attowatt/frekvensHack/README.md

# frekvensHack

[Open the case](#open-the-case)  
[Rewire](#rewire)  
[Make a cable hole](#make-a-cable-hole)  
[Reassemble](#reassemble) 

[Firmware](#firmware) 

[Sources](#sources) 

## Open the case

Open the four screws on the back.

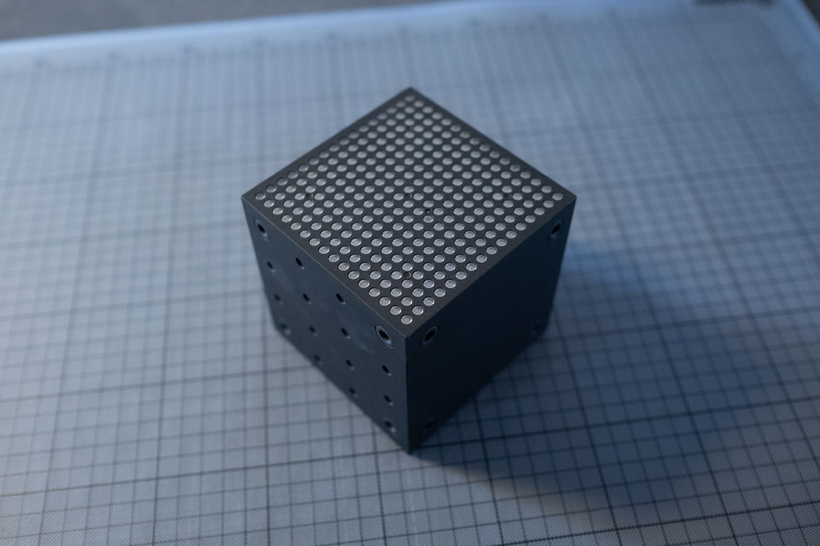
[picture p1: pictures/001.jpg]

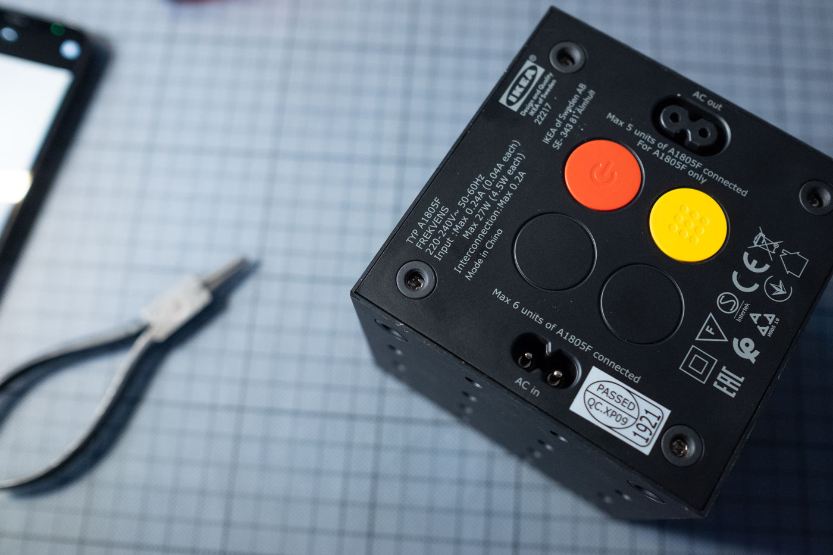
[picture p2: pictures/002.jpg]

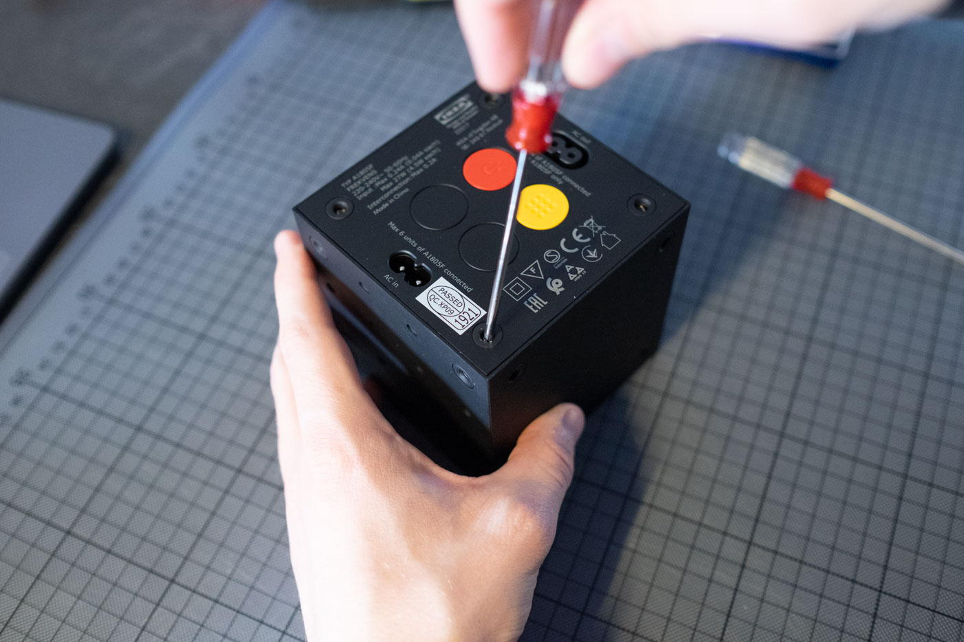
[picture p3: pictures/003.jpg]


Pry open back plate. It is glued, so it might take some light force.

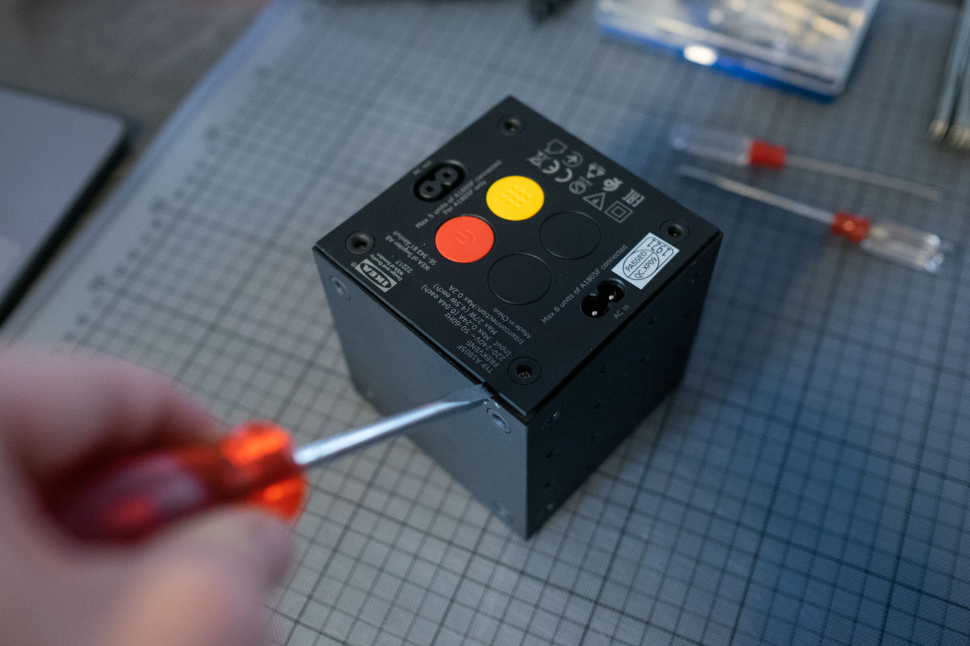
[picture p4: pictures/004.jpg]

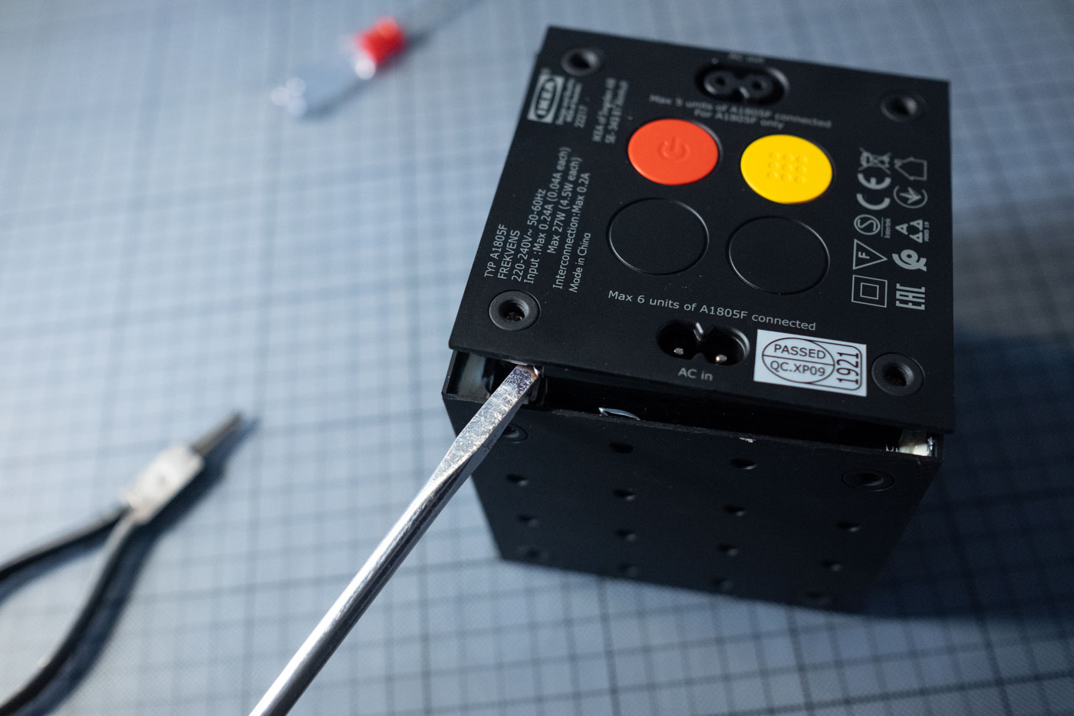
[picture p5: pictures/005.jpg]

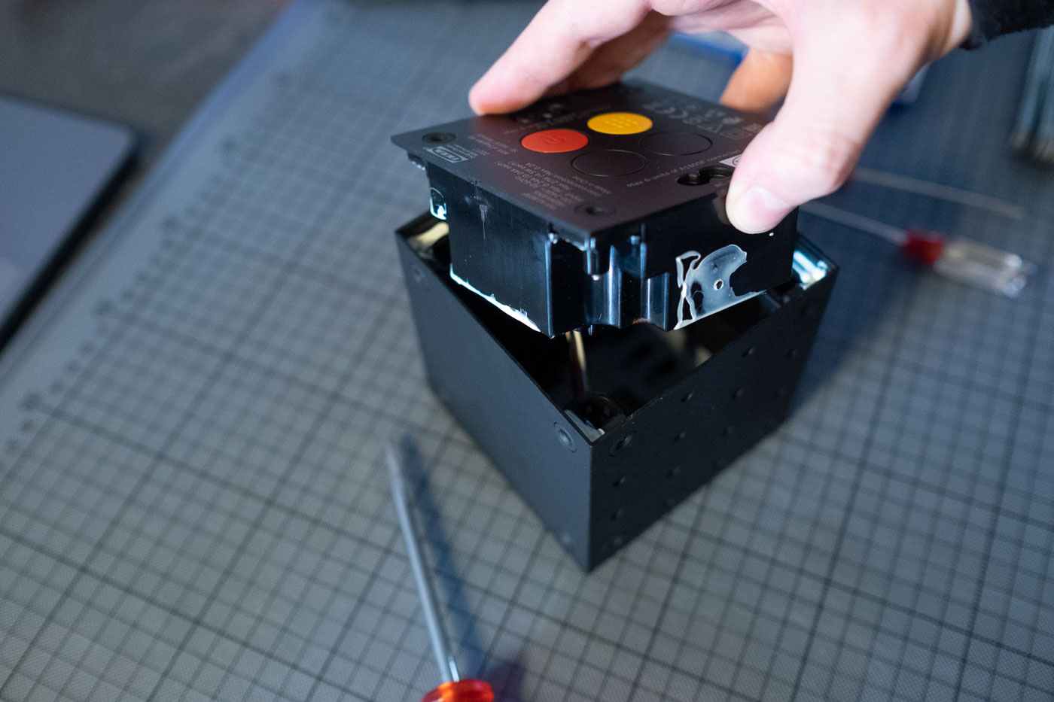
[picture p6: pictures/006.jpg]

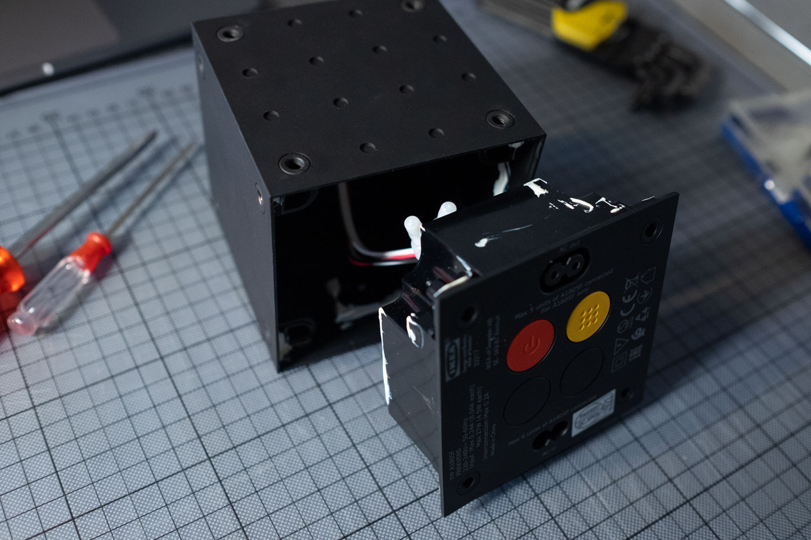
[picture p7: pictures/007.jpg]


Remove the four little corner spacers of the inner frame, each holding two screw nuts in place.

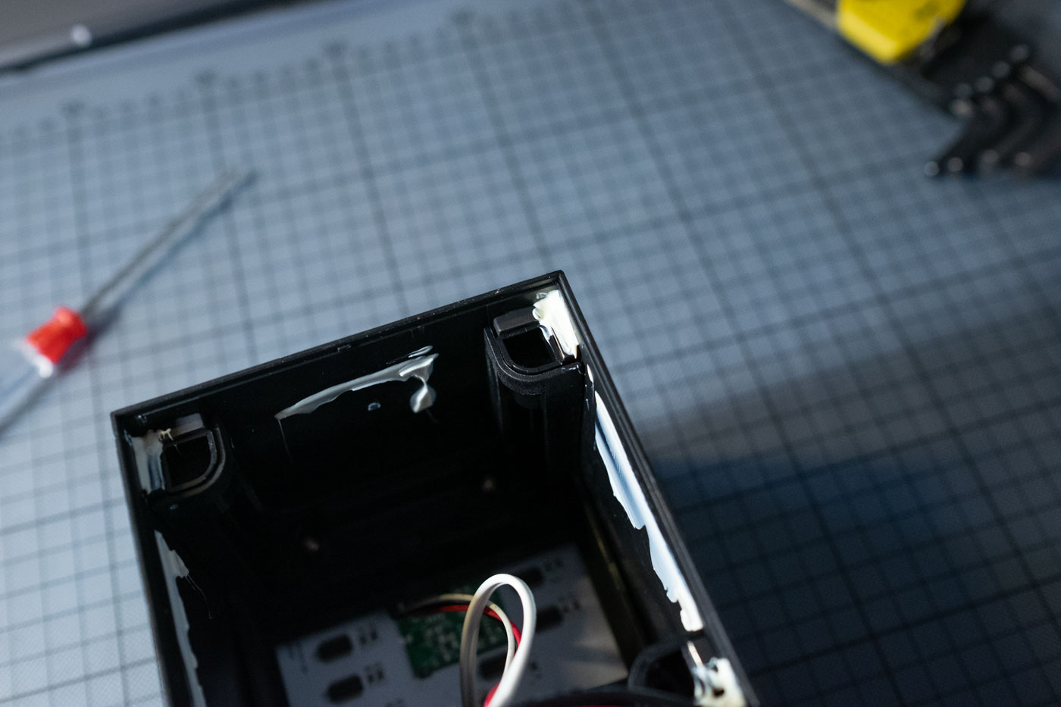
[picture p8: pictures/008.jpg]

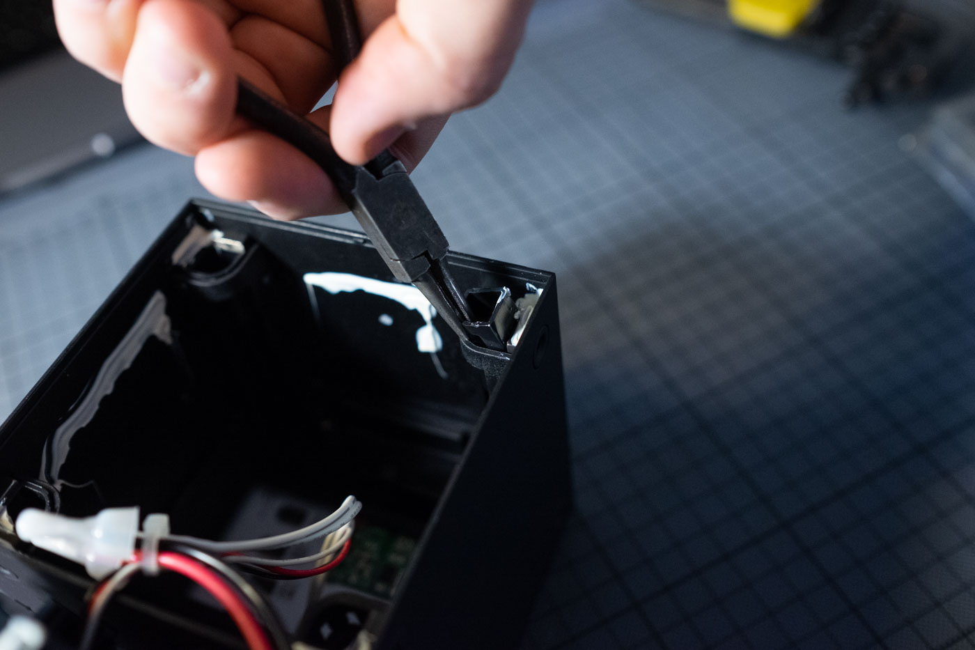
[picture p9: pictures/009.jpg]


Remove the 8 screw nuts, too.

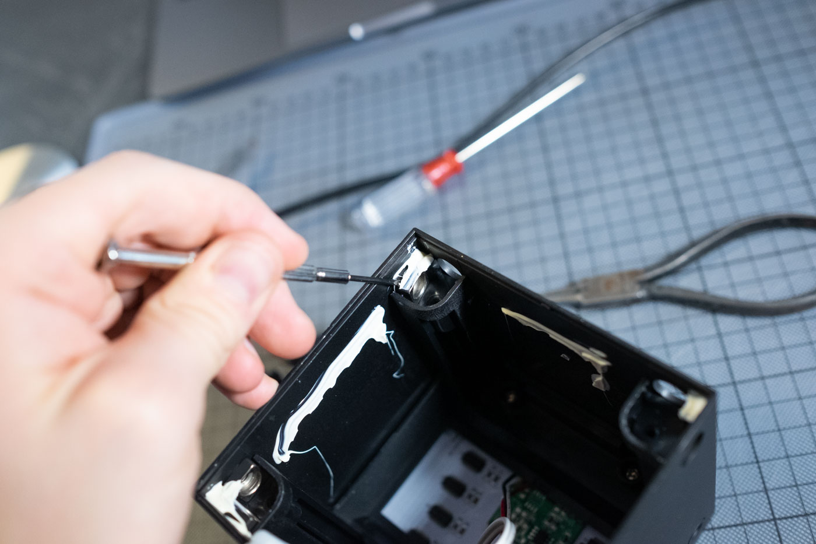
[picture p10: pictures/010.jpg]

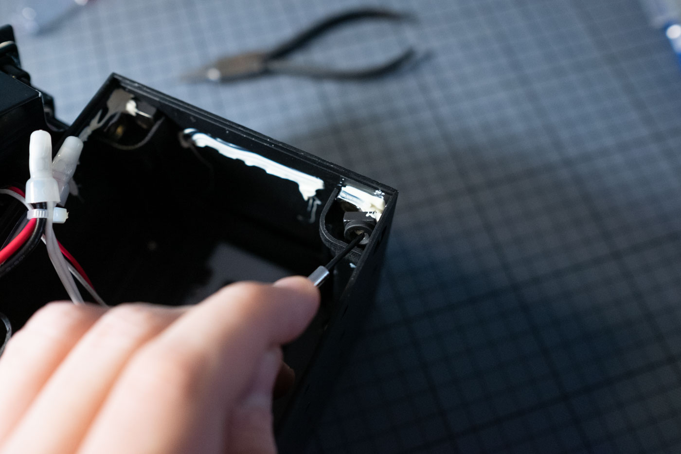
[picture p11: pictures/011.jpg]

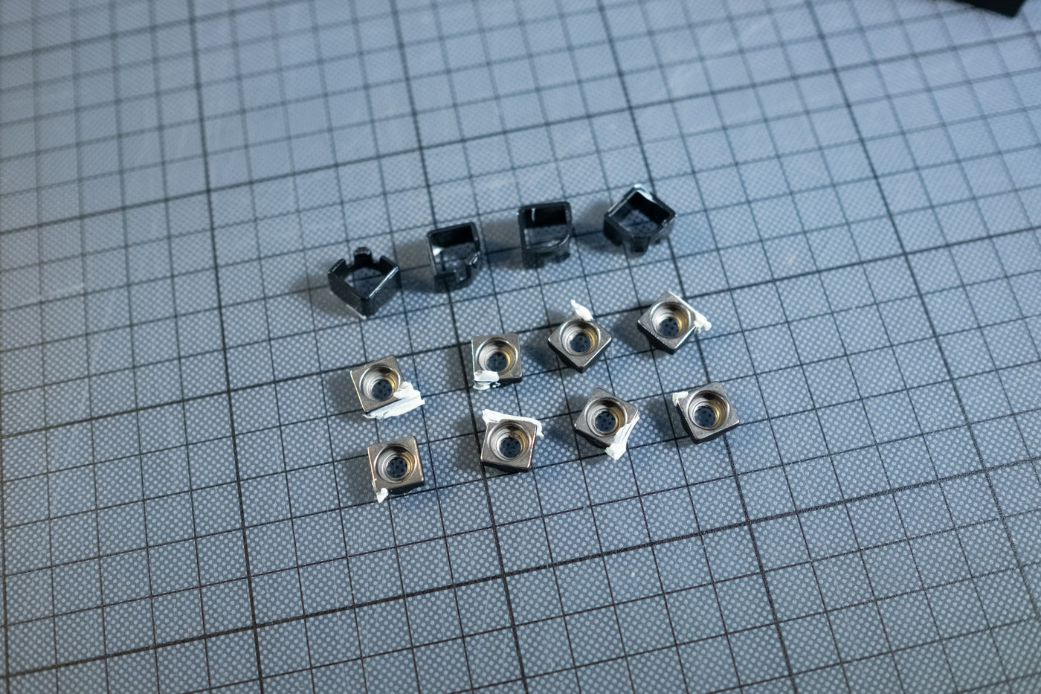
[picture p12: pictures/012.jpg]


The inner frame is held in place by four screws. Open the screws and force the frame out of the case. Once the glue is broken, it should slide up.

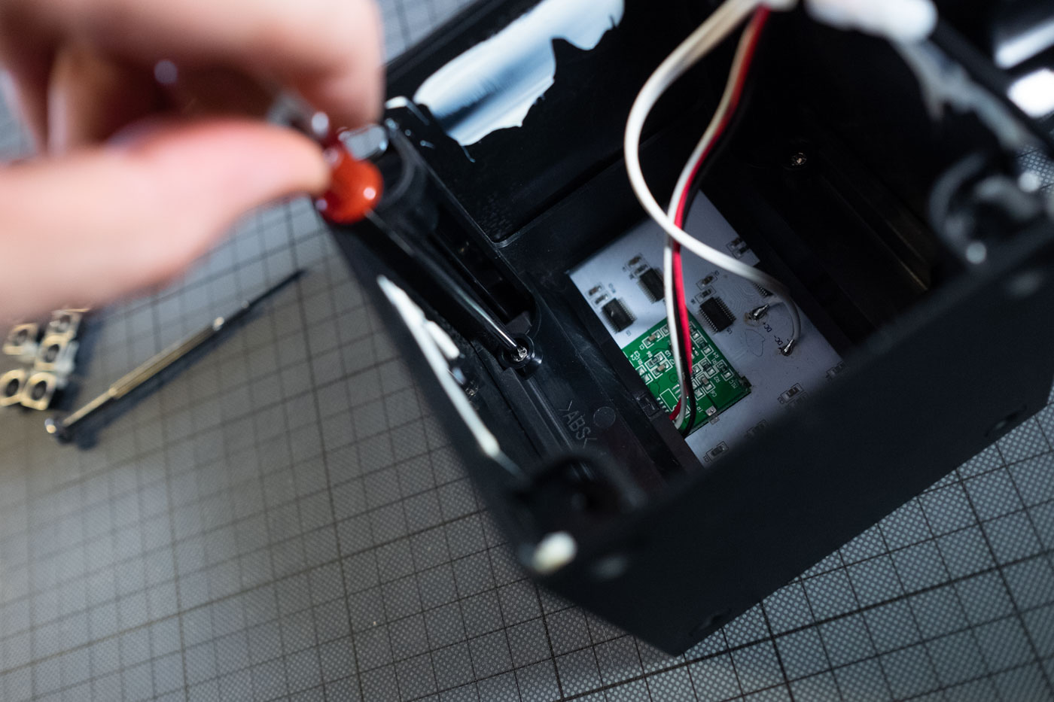
[picture p13: pictures/013.jpg]

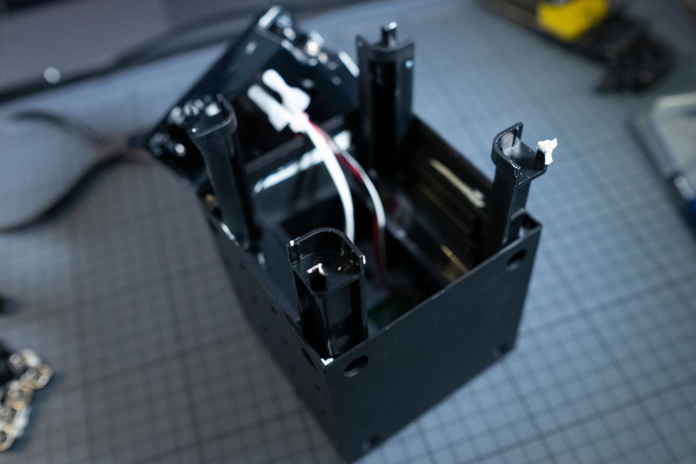
[picture p14: pictures/014.jpg]


There are two horizontal bars sitting under the frame, each holding four more srew nuts. Two of these nuts are visible – remove them. Then take out the bars. Leave the other two nuts in place (as seen on the pictures).

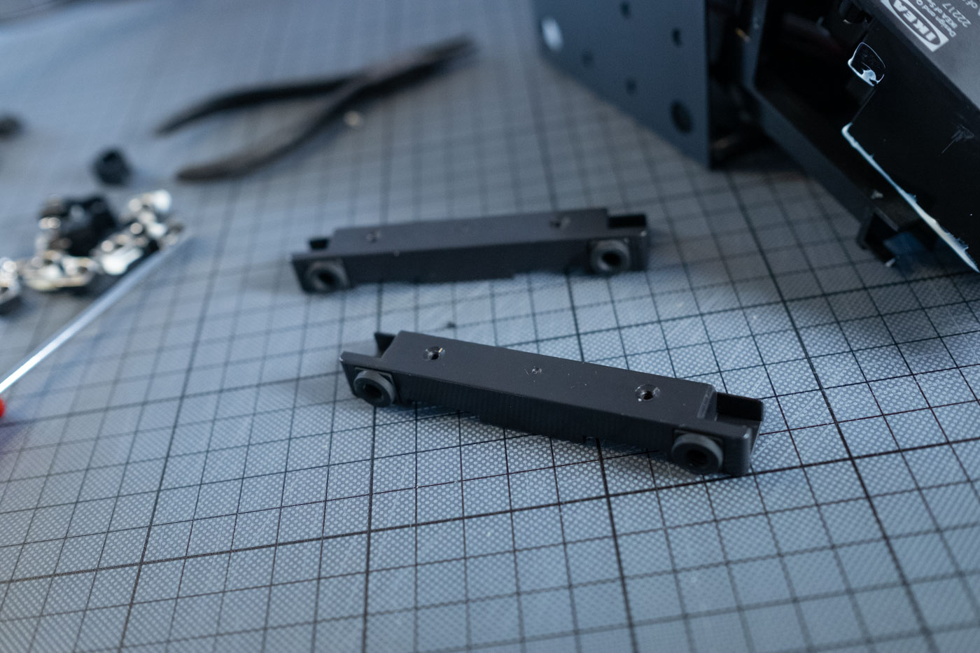
[picture p15: pictures/015.jpg]


Remove the green PCB from the mainboard.

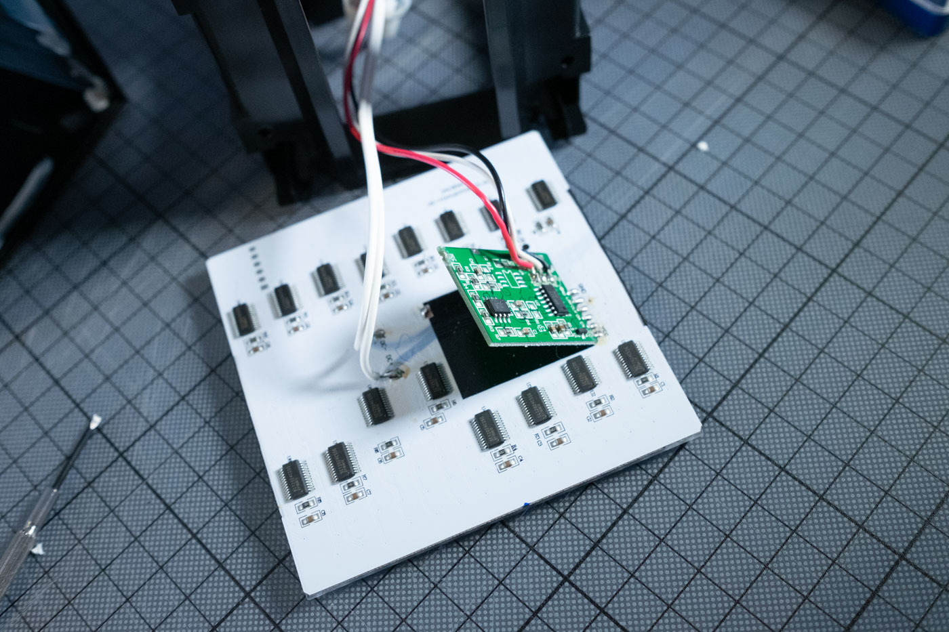
[picture p16: pictures/018.jpg]


The red, black and white wires are for the buttons. Cut them from the PCB.

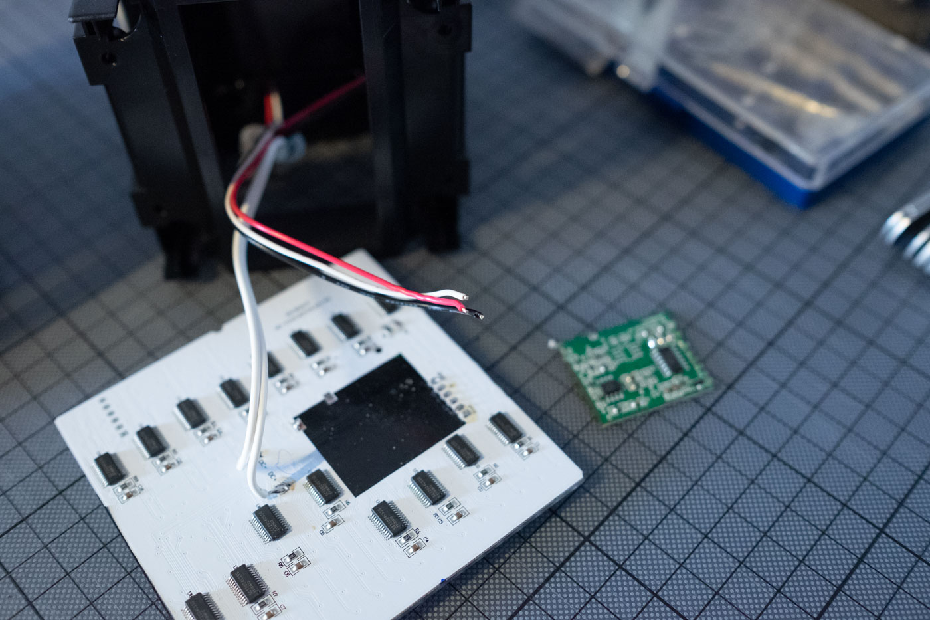
[picture p17: pictures/019.jpg]


## Rewire

There are six connections on the main board. From left to right:

Pin | What it carries | Connect to Teensy
--- | --- | ---
Pin 1 | GND | Connect to Teensy GND
Pin 2 | LATCH | Connect to Teensy Pin 3
Pin 3 | CLOCK | Connect to Teensy Pin 2
Pin 4 | DATA | Connect to Teensy Pin 1
Pin 5 | ENABLE | Connect to Teensy Pin 0
Pin 6 | VCC | Connect to Teensy VIN

The VCC connection has 4 volts coming from the power supply, so it can be used to power the Teensy.

For the buttons:

Wire | What it carries | Connect to Teensy
--- | --- | ---
Red | Common | Connect to Teensy GND
Black | Red button | Connect to Teensy Pin 6
White | Yellow button | Connect to Teensy Pin 5

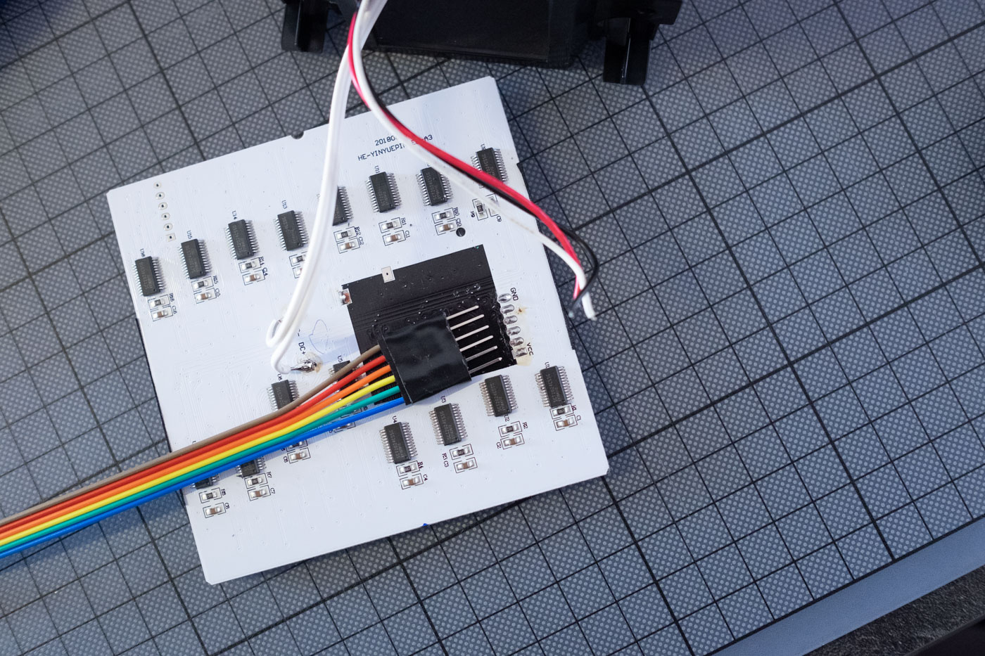
[picture p18: pictures/020.jpg]

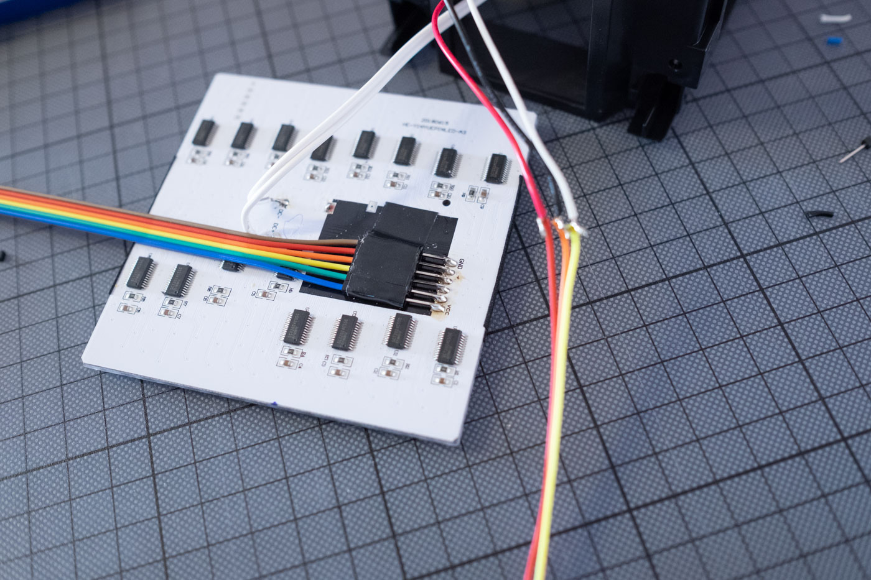
[picture p19: pictures/021.jpg]


I've added a CV input to the Teensy, connected to A9.

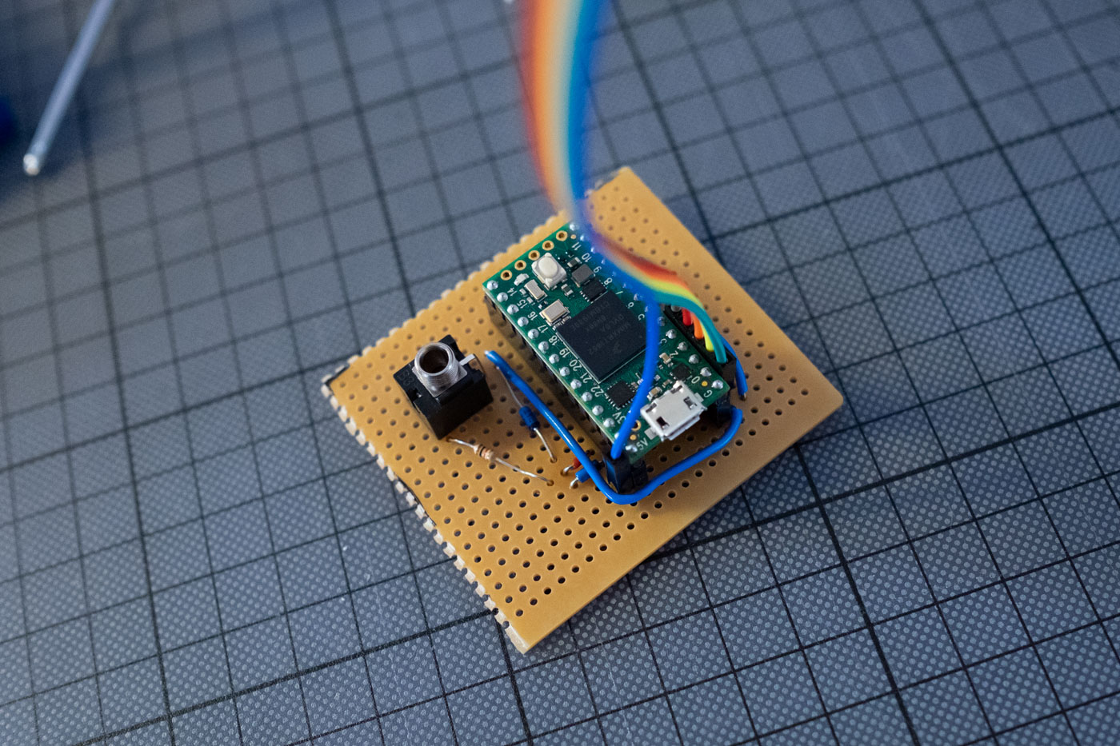
[picture p20: pictures/022.jpg]


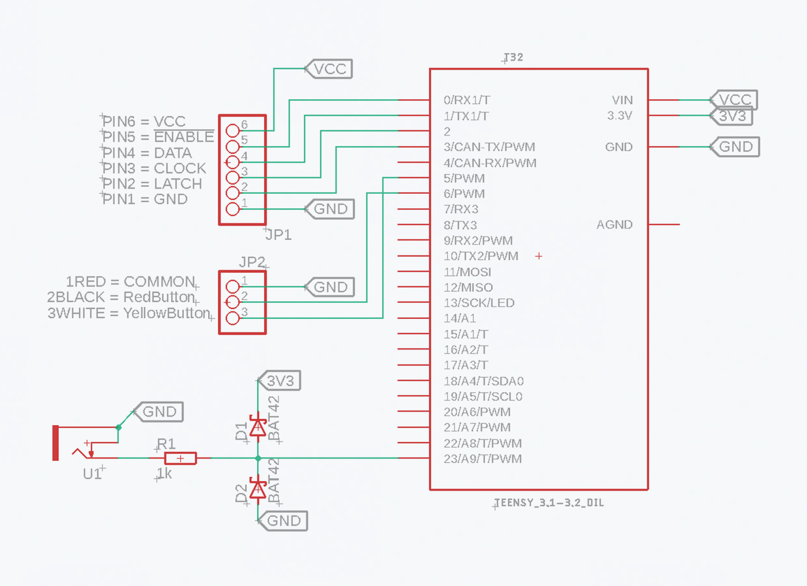
[picture p21: hardware/frekvensHack_schematic.png]


## Make a cable hole

Open the four screws of the power supply. We don't need to open it completely, but just enough to get out the screw nut in the buttom right corner.

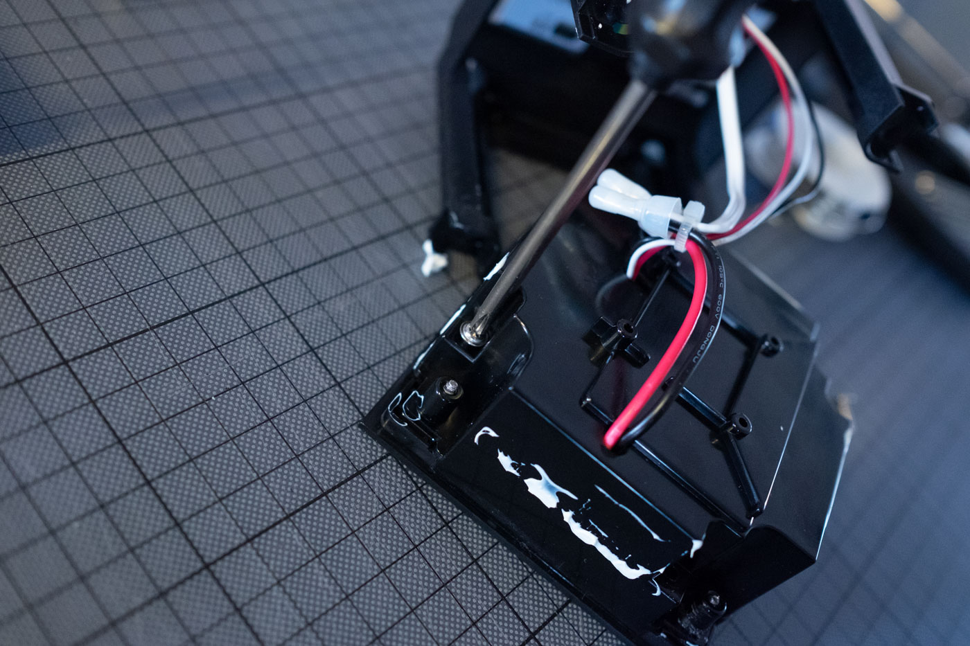
[picture p22: pictures/023.jpg]

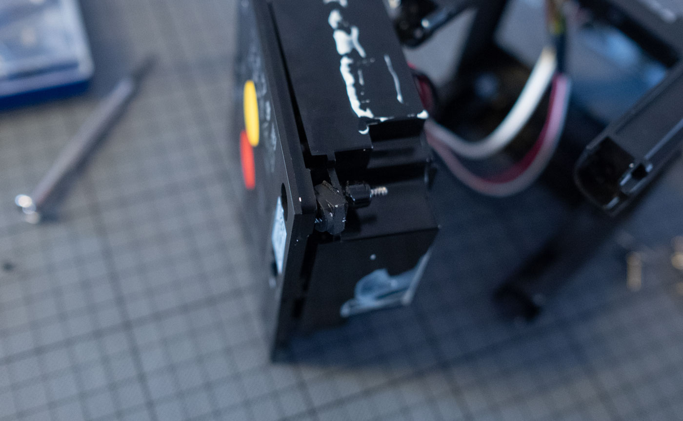
[picture p23: pictures/024.jpg]


Cut out the plastic holding the screw, so there's a nice hole. Feed a USB cable and a patch cable through this hole.

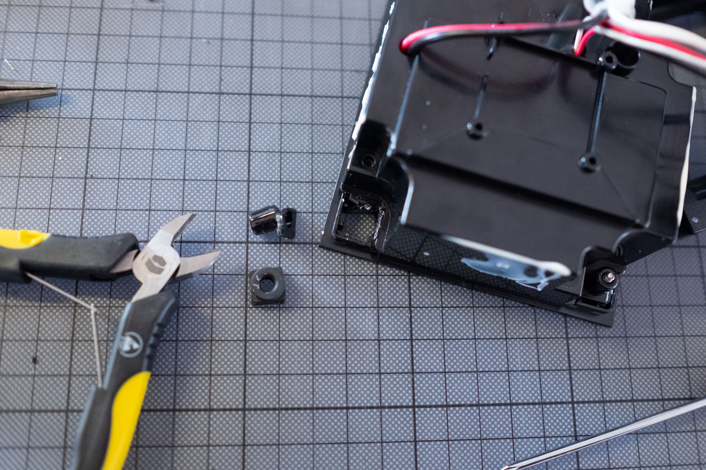
[picture p24: pictures/025.jpg]

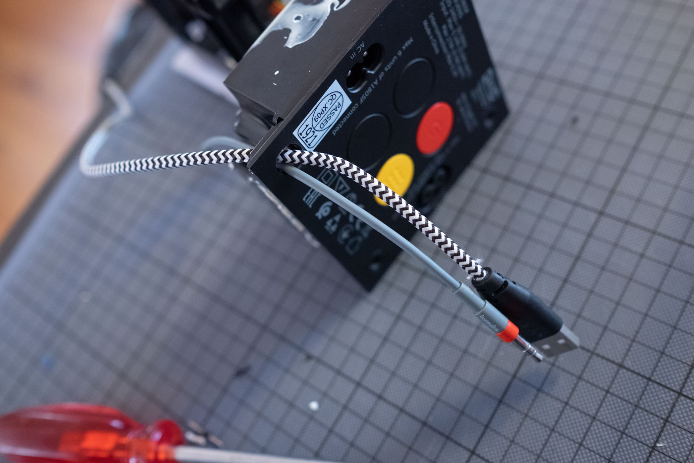
[picture p25: pictures/027.jpg]


Cut out a piece from the same corner of the inner frame, as well as from the corner spacer. Feed the cables through it and place it into position.

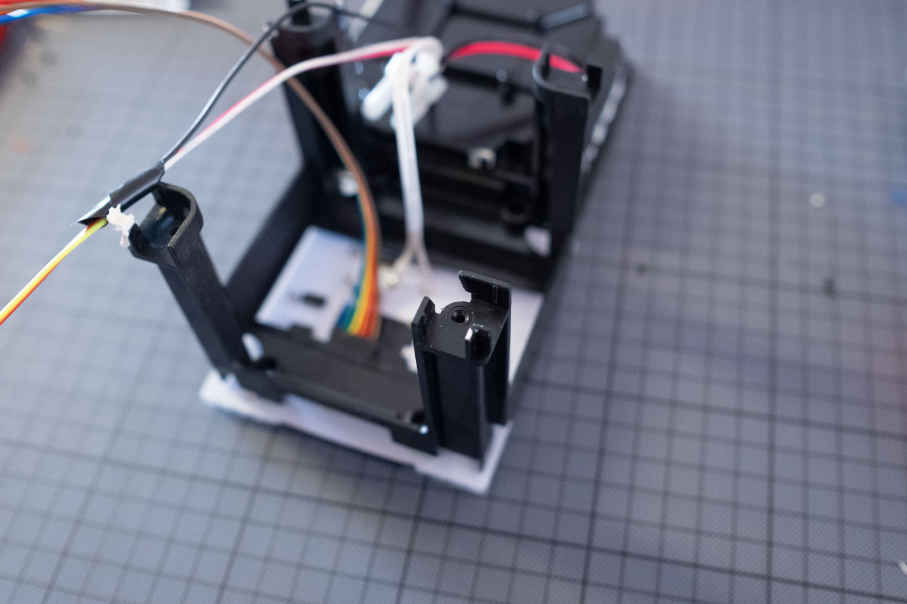
[picture p26: pictures/026.jpg]

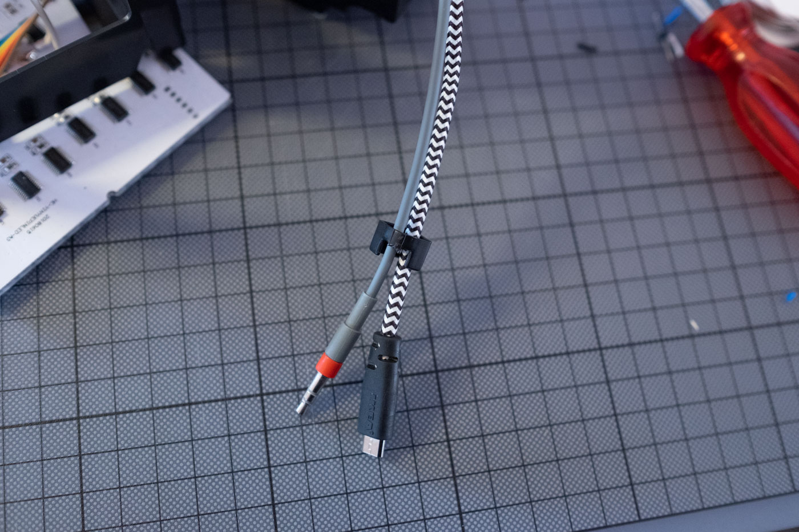
[picture p27: pictures/028.jpg]

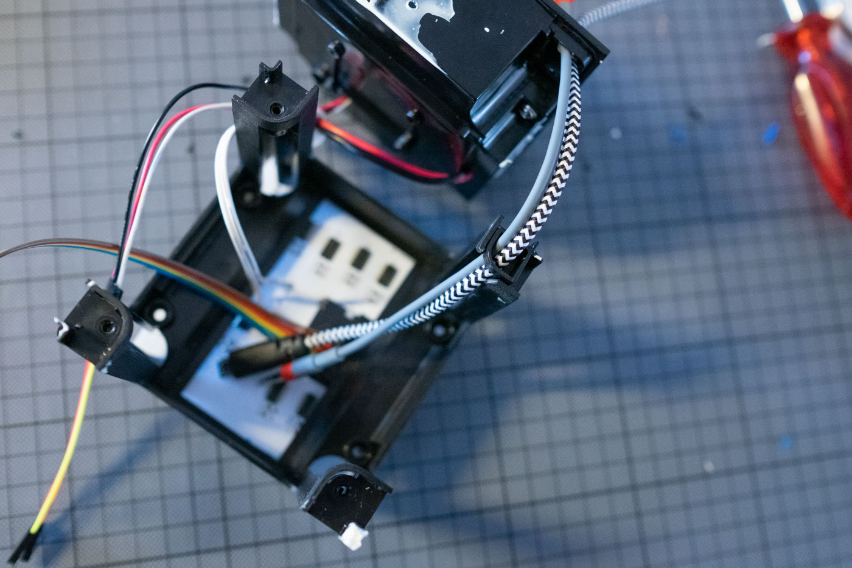
[picture p28: pictures/029.jpg]


Connect the USB cable to the Teensy, and the patch cable into the jack.

## Reassemble

To reassemble the whole cube, start be placing the mainboard on top of the LEDs, then the horizontal bars, then the inner frame on top of the mainboard and the bars. 
Note the orientation of each part:
- The outer case has a little tip and the mainboard has a corresponding cutout.
- Position so that tip and cutout are on the right side. "DC-" and "DC+" on the mainboard will read upside down, "HE-YINYUEPINLED-A3" will read top to bottom.
- Position the frame, so it reads ">ABS< 1" horizontally. 

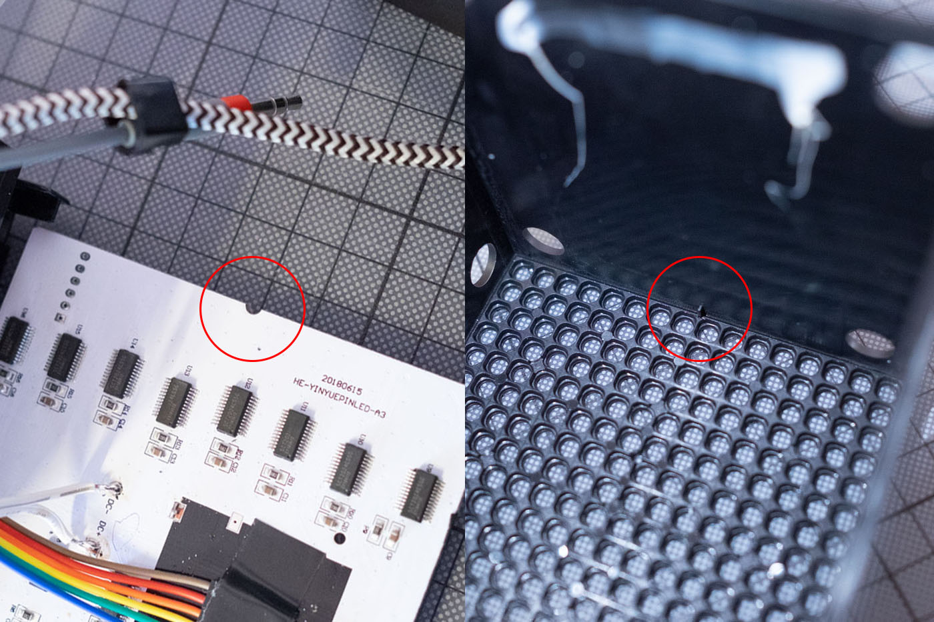
[picture p29: pictures/030.jpg]

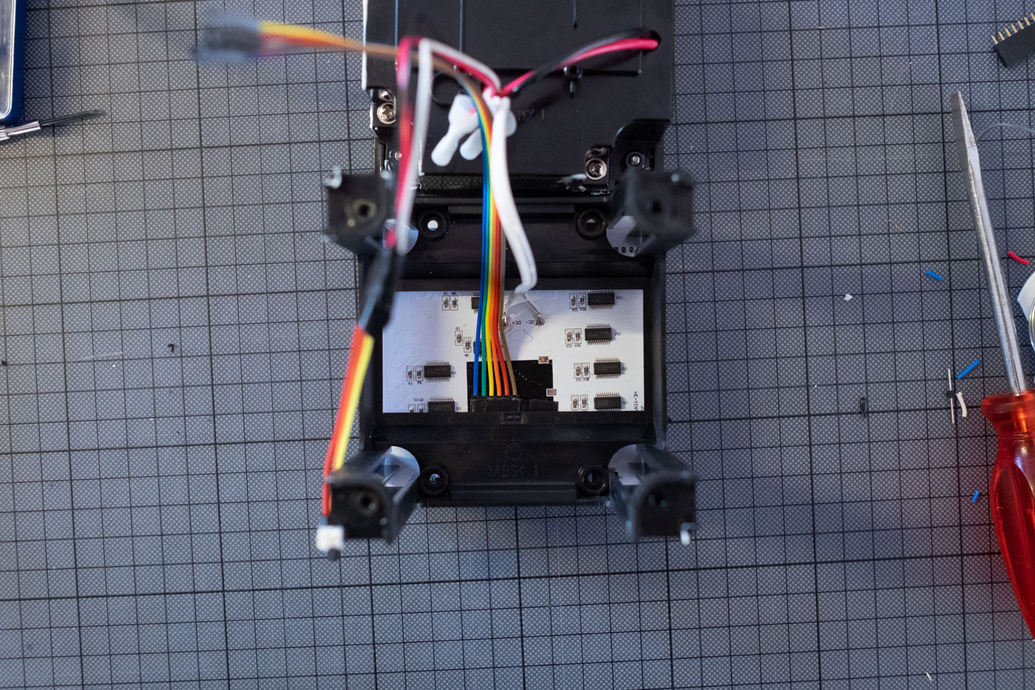
[picture p30: pictures/031.jpg]


Now push everything into the outer case. Then lift the inner frame again and place two screw nuts inside on the left and right side of each horizontal bar. Once in place, push everything back into the frame. Then add the 8 screw nuts and corner spacers into the corners of the inner frame. Finally, place the power supply part with the back panel on top. Screw down.

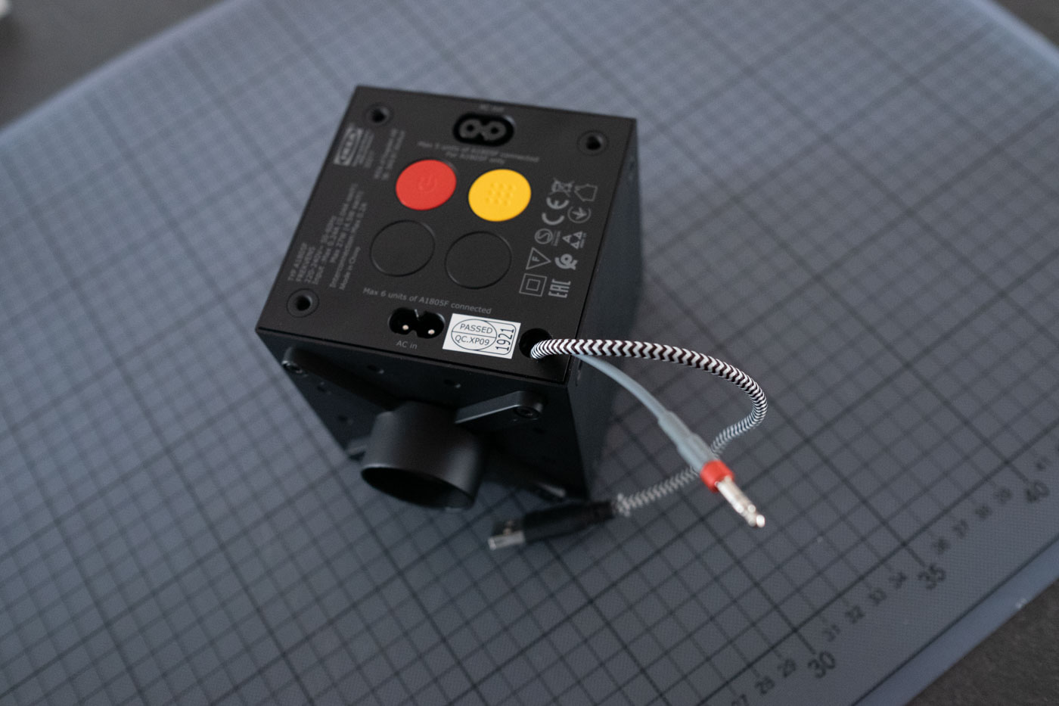
[picture p31: pictures/033.jpg]

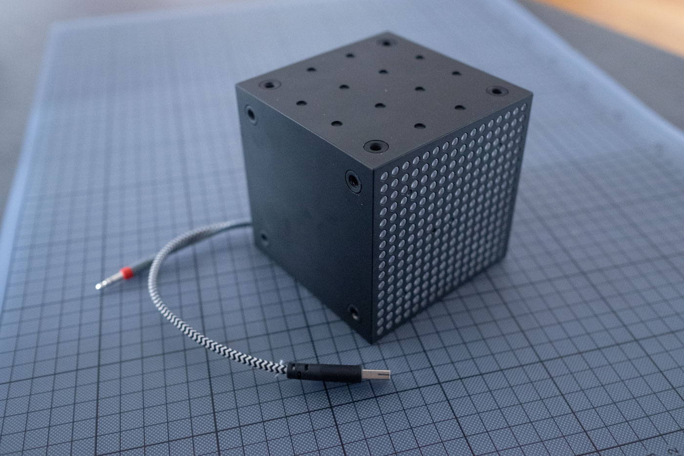
[picture p32: pictures/034.jpg]


## Firmware

The Teensy code is using [frumperino](https://github.com/frumperino)'s great [Arduino library](https://github.com/frumperino/FrekvensPanel) for the Frekvens LED cube and based on the corresponding examples. See the library for more info.

## Sources

- Frumperino's FrekvensPanel library (https://github.com/frumperino/FrekvensPanel)
- hymenochirus' Teardown on imgur (https://imgur.com/gallery/OBj0aC7)
