attowatt/frekvensHack/pictures/016.jpg

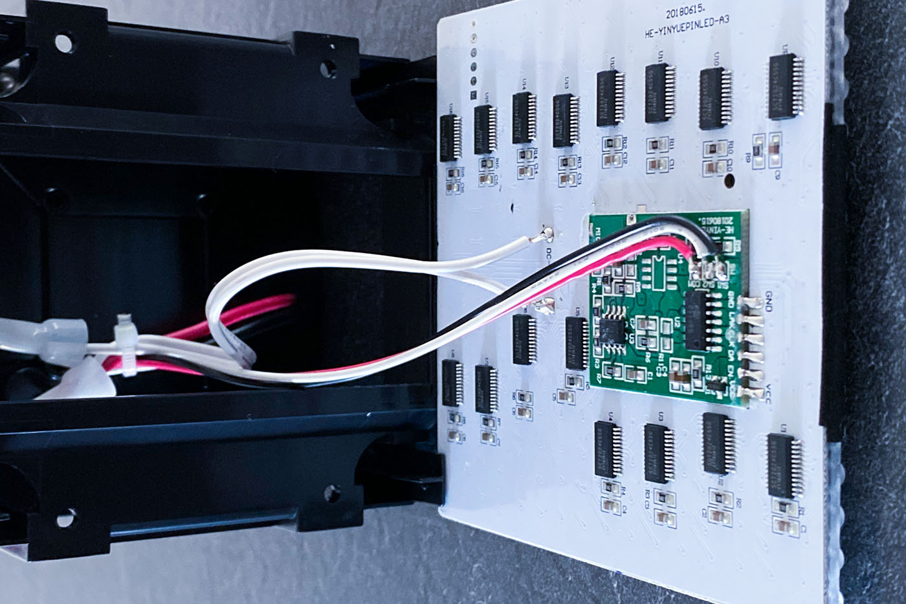
pictures/016.jpg
