attowatt/frekvensHack/pictures/017.jpg

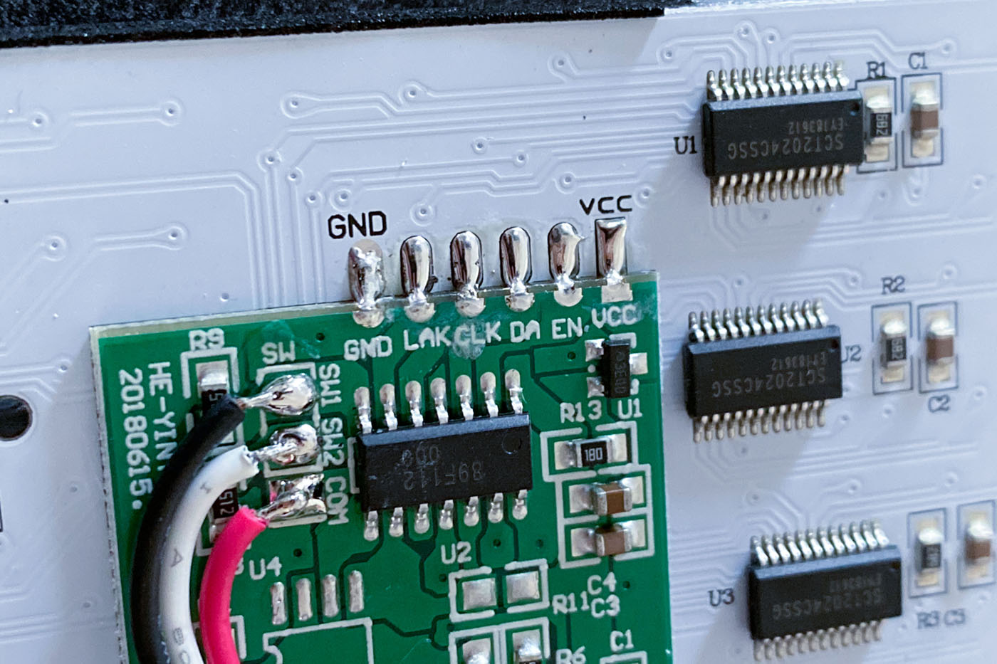
pictures/017.jpg
