attowatt/frekvensHack/pictures/032.jpg

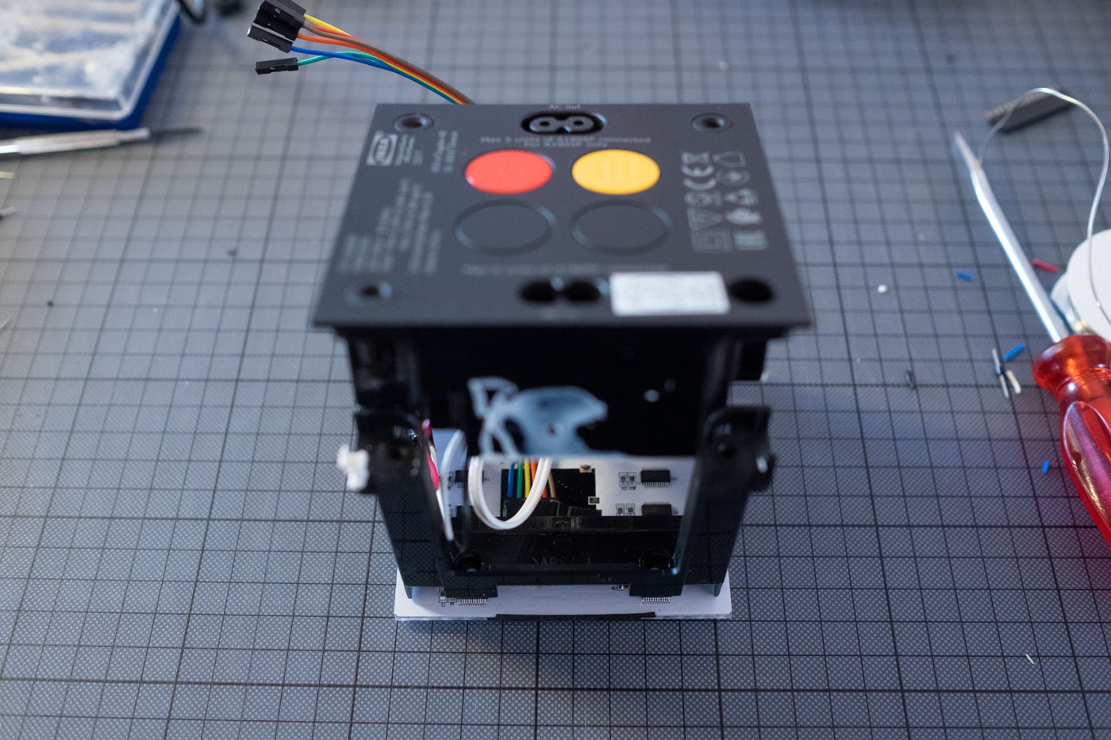
pictures/032.jpg
