attowatt/frekvensHack/hardware/frekvensHack_schematic.sch

## EAGLE design hardware/frekvensHack_schematic.sch (2021-05-15)

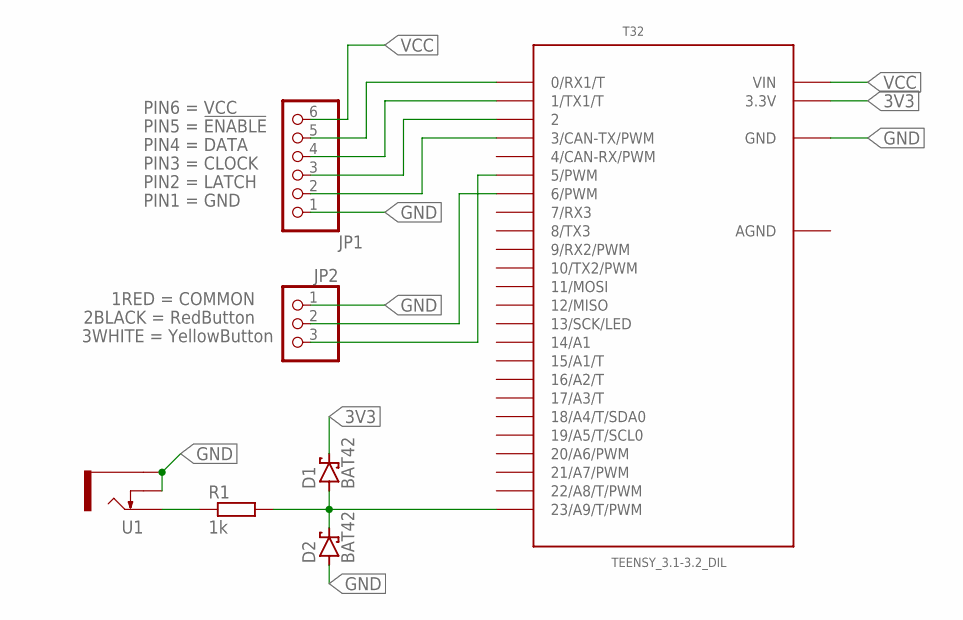
[picture p36: schematic frekvensHack_schematic.sch]

Parts:
D1, D2: BAT42; DO35-10
JP1: PINHD-1X6; 1X06
JP2: PINHD-1X3; 1X03
R1: 1k; 10MM_RESISTOR
T32: TEENSY_3.1-3.2_DIL; TEENSY_3.0-3.2&LC_DIL
U1: THONKICONNNEW; WQP-PJ301M-12_JACK

Connections:
3V3: D1.C, T32.3.3V
GND: D2.A, JP1.1, JP2.1, T32.GND, U1.P$2_SWITCH (SWITCH), U1.P$3_SLEEVE (SLEEVE)
unnamed: JP1.5, T32.0 (0/RX1/T)
unnamed: JP1.4, T32.1 (1/TX1/T)
unnamed: JP1.3, T32.2
unnamed: JP1.2, T32.3 (3/CAN-TX/PWM)
unnamed: JP2.3, T32.5 (5/PWM)
unnamed: JP2.2, T32.6 (6/PWM)
unnamed: D1.A, D2.C, R1.2, T32.23/A9 (23/A9/T/PWM)
unnamed: R1.1, U1.P$1_TIP (TIP)
VCC: JP1.6, T32.VIN
